i4/timecube/(list of files, drawings)

Other design files:
schema.fzz
