i4/timecube/INSTALL.md

Installation der Firmware
=========================

Die Firmware des Zeitwürfels kann entweder über *Arduino IDE* oder *ESP IDF* übersetzt und übertragen werden.

Arduino IDE
-----------

*Arduino* erlaubt einen schnellen Einstieg, allerdings sind erweiterte (stromsparendere) Konfigurationsmöglichkeiten hier nicht möglich.

### Vorbereitung

  1. Aktuelle [Arduino IDE](https://www.arduino.cc/en/main/software) installieren
  2. Unter Windows den (unsignierten) [FireBeetle ESP32 Treiber](https://git.oschina.net/dfrobot/FireBeetle-ESP32/raw/master/FireBeetle-ESP32.inf) installieren.
  3. Arduino Umgebung für den FireBeetle ESP32 gemäß [DFRobot Wiki](https://wiki.dfrobot.com/FireBeetle_ESP32_IOT_Microcontroller(V3.0)__Supports_Wi-Fi_&_Bluetooth__SKU__DFR0478) hinzufügen:
     * Unter *Datei* / *Voreinstellungen* als *Zusätzliche Boardverwalter-URLs* die Adresse `http://download.dfrobot.top/FireBeetle/package_esp32_index.json` eingeben und mittels *OK* bestätigen
     * Unter *Werkzeuge* / *Board: ...* den *Boardverwalter...* öffnen, das automatische Update abwarten und dann den *FireBeetle-ESP32-Mainboard by DFRobot DFRDuino* in einer aktuellen Version (0.0.9) installieren

### Verwendung

  1. Die Arduino IDE starten und `firmware/sketch_timecube/sketch_timecube.ino` öffnen -- weitere Tabs mit den restlichen Dateien werden ebenfalls geladen
  2. Unter *Werkzeuge* / *Board: ...* den *FireBeetle-ESP32* auswählen
  3. Die Datei `config.h` anpassen, ggf. weitere Änderungen vornehmen
  4. Mit *Überprüfen/Kompilieren* unter *Sketch* die getätigten Änderungen prüfen.
  5. Den Zeitwürfel per USB mit dem PC verbinden und unter *Werkzeuge* / *Port* entsprechend auswählen (z.B. `/dev/ttyUSB0`)
  6. Ebenfalls unter *Werkzeuge* den *Uploadspeed* auf `115200` stellen und ebenda *Serieller Monitor* starten
  7. Unter *Sketch* / *Hochladen* das Übertragen der Firmware starten. Und warten.
  8. Auf dem seriellen Monitor erscheint eine Ausgabe nach erfolgreichem Start.

ESP IDF
-------

Das *Espressif IoT Development Framework* ist das offizielle Entwicklungsframework für den ESP32 und erlaubt (durch die Datei `sdkconfig`) eine erweiterte Konfiguration des zugrunde liegenden [FreeRTOS](https://www.freertos.org/)-Kernels, wie z.B. eine niedrigere Taktfrequenz.

### Voraussetzungen

Folgende Komponenten werden benötigt:

  * [xtensa-esp32-Toolchain](https://docs.espressif.com/projects/esp-idf/en/release-v3.3/get-started/linux-setup.html)
  * [ESP IDF *in Version 3.3*](https://github.com/espressif/esp-idf) (die verwendeten Arduino-Erweiterungen kommen aktuell mit neuen Versionen nicht zurecht)

### Vorbereitung

Die Konfiguration in der Datei `firmware/main/config.h` muss erstellt werden,
dazu die Vorlage unter `firmware/main/example-config.h` verwenden.

Auf einem debianoiden Linux mit aktueller Version können die benötigten Komponenten wie folgt installiert werden:

    # Dieses Repo für Firmware rekursiv auschecken
    git clone https://gitlab.cs.fau.de/i4/timecube.git
    cd timecube
    git submodule update --init --recursive
    # Benötigte Pakete installieren
    sudo apt-get install make cmake git wget flex bison gperf python3 python3-pip python3-setuptools python-is-python3 libffi-dev libssl-dev
    # ESP IDF Version 3.3 rekursiv auschecken
    cd firmware
    git clone --depth=1 --recursive --branch v3.3.6 https://github.com/espressif/esp-idf.git
    export IDF_PATH="$(readlink -f esp-idf)"
    # Benötigte Python Pakete installieren
    pip3 install -r $IDF_PATH/requirements.txt
    # Bluetooth Abhängigkeitsproblem lösen (BLE wird nicht benötigt)
    sed -i '/^#include <protocomm_ble.h>$/d' $IDF_PATH/components/wifi_provisioning/include/wifi_provisioning/scheme_ble.h
    # xtensa-esp32-Toolchain laden (URL von der [Linux-setup](https://docs.espressif.com/projects/esp-idf/en/release-v3.3/get-started/linux-setup.html) Webseite)
    wget -qO- https://dl.espressif.com/dl/xtensa-esp32-elf-linux64-1.22.0-97-gc752ad5-5.2.0.tar.gz | tar xvz
    export PATH="$PATH:$(readlink -f xtensa-esp32-elf/bin)"

### Bauen der Firmware

Nach der Vorbereitung im `firmware`-Verzeichnis folgende Schritte ausführen:

    mkdir build
    cd build
    cmake ..
    make

### Flashen des Zeitwürfels

Mittels `make flash` kann die Firmware dann auf den via USB verbundenen Würfel übertragen werden.
Hat man mehr als einen ESP32 angeschlossen, dann kann/muss man mittel Umgebungsvariable `ESPPORT` angeben, welcher Chip geflasht werden soll:
`ESPPORT=/dev/ttyUSB5 make flash`

Docker (mit ESP IDF)
--------------------

Wer weder *Arduino* noch das *Espressif IoT Development Framework* installieren will, kann auch alternativ Docker verwenden.

### Bauen des Docker Abbildes (optional)

Wer das Docker Image selbst bauen will, kann dies mittels

    docker build -t inf4/timecube .

im Hauptverzeichnis des Repos machen.

Alternativ ist es aber auch fertig auf [Docker Hub](https://hub.docker.com/r/inf4/timecube/) verfügbar und wird im nachfolgenden Schritt automatisch geladen.

### Bauen der Firmware und Flashen des Zeitwürfels

Auch hier muss zuerst eine Konfiguration (im Beispiel `config.h` im aktuellen Verzeichnis) erstellt werden,
wozu die Vorlage im Repo unter `firmware/main/example-config.h` verwendet werden kann.

    docker run --rm -it -v $(pwd)/config.h:/timecube/firmware/main/config.h --device=/dev/ttyUSB0 inf4/timecube

Webfrontend
===========

Der Zeitwürfel läd die Daten regelmäßig über das WLAN an das Frontend.
Dafür wird ein Webserver mit PHP und einer PostgreSQL Datenbank benötigt (kann aber leicht zu einer anderen Datenbank geändert werden, siehe `server/www/index.php:18`).
Die Zugangsdaten werden in `server/www/config.php` konfiguriert, ein Beispiel ist unter `server/example-config.php` zu finden.

Lokal
-----

Das Frontend des Zeitwürfels kann einfach in eine bestehende Serverinfrastruktur integriert werden.

### Webserver

Es muss sichergestellt werden, dass die Submodule im Repo geladen sind:

    git submodule init
    git submodule update

Danach muss lediglich noch das Verzeichnis `server/www/` über die Webserverkonfiguration zugänglich gemacht werden.

### Datenbank

Eine neue Datenbank muss erstellt werden, das Schema ist unter `server/database.sql` zu finden.
Um neue Benutzer anzulegen, wird die MAC Adresse des Würfels benötigt (kann z.B. über eine serielle Konsole beim verbundenen Zeitwürfel ausgelesen werden), die Datei `server/insert_new_user.sql` zeigt den dafür notwendigen SQL Query.

Docker
------

Alternativ kann das ganze Webfrontend (Webserver und Datenbank) auch in Docker gestartet werden, dazu gibt es mit `server/docker_compose.yml` eine vorgegeben Spezifikation, welche einfach gestartet werden kann:

    cd server
    docker-compose up -d

und schon kann über http://localhost/ zugegriffen werden
(für den Beispielbenutzer `chris` einfach http://localhost/chris/ aufrufen)

Dieser Dienst muss nun noch über das Netzwerk erreichbar sein, die Würfelkonfiguration muss den dazu passenden Host haben.
