i4/timecube/(commit log)

2019-02-12 Arduino project
2019-02-12 Laser cut template
2019-05-05 heatmap 2
2019-06-10 Add assembly instructions
2019-06-12 Lasercut templates
2019-06-18 lasercut-firebeetle-3mm: Fix incorrect material width (was 4mm, should be 3mm)
2019-06-20 Aktualisieren images/schema.png, schema.fzz, montage.md Dateien
    [schema.fzz]
2019-06-25 Update montage.md / lasercut infos
2019-07-03 insert sql script
2019-07-04 fixed heatmap
2019-07-08 improved arduino sketch
2019-07-18 Fix calculation of current week and current month for work cycle
    Week:
    The current time was used in the end date of the week.
    This caused the day the be counted as another full workday.
    A week now correctly goes from Monday, midnight to next Monday,
    midnight.
    Month:
    The end of the month is now set to the first day of the next month,
    midnight, matching how the number of workdays is calculated for
    weeks and years (1st of X to 1st of X+1).
2019-07-22 Enable Click Interrupt, disable (buggy) explicit esp_wifi_stop
2019-08-01 WorkCycleData: Initialise weekEnd with weekStart to always get correct month
    If weekEnd is initialised with the current date, the calculation breaks when a week
    spans two months.
    The new month will then be combined with the old months day, resulting in an additional
    month added to weekEnd.
    E.g. In a week starting on Monday, 30.07 weekEnd was calculated as (30.08 + 7days = 06.09)
    from Wednesday on
2019-08-26 Add Makefile to get rid of arduino GUI
2019-08-27 Properly calculate battery voltage from ADC reading (incl. ADC characterization)
2019-08-27 ws-only: Fixup accelerometer.{cpp,h}
2019-08-27 Replace german debug strings with english ones
    [sketch_timecube.cpp]
2019-09-10 update fritzing
    [schema.fzz]
2019-11-11 Add Arduino Support (again)
2022-04-06 Fix typo in config.h and rename to example-config.h
    [example-config.h]
2022-04-06 Use carriage return and line feed for serial output
